desiFish/EPaper-Display-NTP-Clock/src/images/x6.jpg

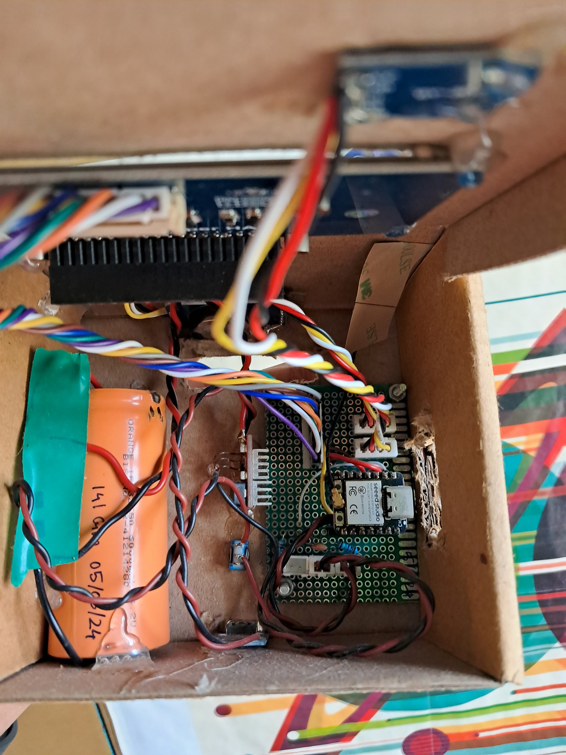
src/images/x6.jpg
