desiFish/EPaper-Display-NTP-Clock/(threads)

Thread 2 (2024-06-30):

Add Settings Button

KamadoTanjiro-beep, 2024-06-30:
A settings button is needed for entering WiFi manager page.

desiFish, 2024-12-30:
Successfully tested the debug/settings switch on Weather Clock, the same can be applied to this clock

Thread 7 (2025-01-11):

Interrupt Based Update

desiFish, 2025-01-11:
Connection of INT Pin of DS3231 to wake up esp32 from deep sleep and update time. Internal RTC-based wakeup works just fine, but with one drawback: ESP32 has no way of knowing if a minute has passed in real-time so it may wake up a bit sooner or later. The time displayed on the Epaper display will always be within a 1-minute range. But with INTERRUPT-based-wake-up, it will always show accurate time.

Resource:
[Link1](https://garrysblog.com/2020/07/05/using-the-ds3231-real-time-clock-alarm-with-the-adafruit-rtclib-library/)
[Link2](https://wiki.eolab.de/doku.php?id=amc2020:group_n:deepsleep)

desiFish, 2025-04-06:
done

Closed 2025-04-06.
