desiFish/EPaper-Display-NTP-Clock/(commit log)

2025-01-10 Add important safety notes and warnings regarding battery configuration, USB charging, voltage compatibility, and enclosure design to README.md
2025-01-10 Update image paths in README.md to reflect new directory structure and add battery performance analysis section
2025-01-10 Add additional battery life analysis tests and enhance image gallery in README.md
2025-01-10 Update README.md with display specifications, current draw values, and improved image descriptions
2025-01-10 reverting back to previous stable version
    [epdNtpClockV1.ino]
2025-01-10 Update image and caption for ESP32 C3 & C6 in README.md
2025-01-10 Add battery life analysis table and update performance metrics in README.md
2025-01-11 Update battery life analysis table and add safety notes for DS3231 and TP5000
2025-01-14 Update README.md to clarify deep sleep current specifications and enhance description of ESP32 C6 variant
2025-01-29 (untested) Improved efficiency of overall code.
    Better organisation
    Univeral XIAO Devices compatibility
    Other fixes.
    [epdNtpClockV1.ino, epdif.h]
2025-04-05 Latest fix for time not displaying
    [epd3in52.ino, epdNtpClockV1.ino]
2025-04-05 Refactor battery monitoring and font variable declarations for clarity and efficiency
2025-04-05 Fix component name in README.md and update pin definitions for ESP32 C6 in epdif.h
    [epdif.h]
2025-04-05 Fix formatting issue in README.md for deep sleep current note
2025-04-05 Update USB connection warning for ESP32C6 and clarify battery disconnection instructions
2025-04-06 Refactor autoTimeUpdate function for improved clarity and efficiency; update error handling and battery level display logic
    [epdNtpClockV1.ino]
2025-04-06 Update README.md for improved clarity on display specifications, power source, and deep sleep implementation details
2025-04-06 Fix typo in README.md regarding DS3231 RTC pin connection
2025-04-07 Added new images, memory optimisations, performance optimisations, documentation improvements, upgraded battery UI
2025-09-09 Update battery life analysis test number in README.md
