desiFish/EPaper-Display-NTP-Clock/src/images/x11.jpg

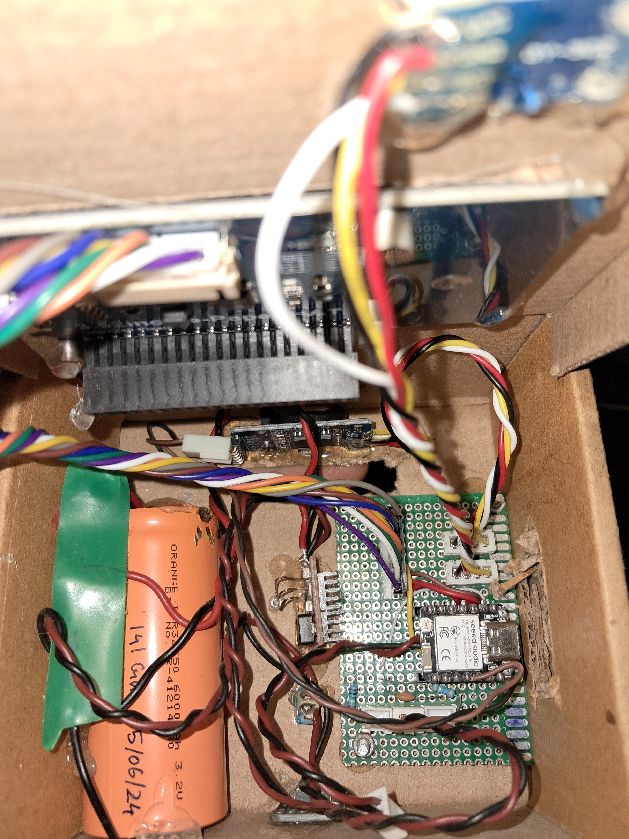
[picture p17: src/images/x11.jpg]
src/images/x11.jpg
