desiFish/EPaper-Display-NTP-Clock/src/images/x12.jpg

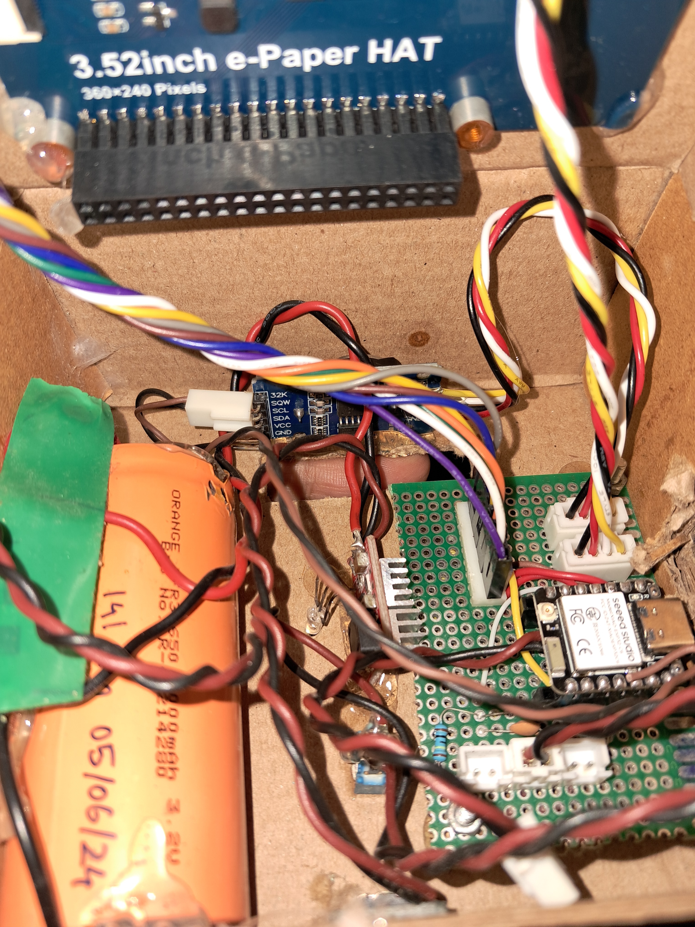
[picture p18: src/images/x12.jpg]
src/images/x12.jpg
