desiFish/EPaper-Display-NTP-Clock/src/images/x13.jpg

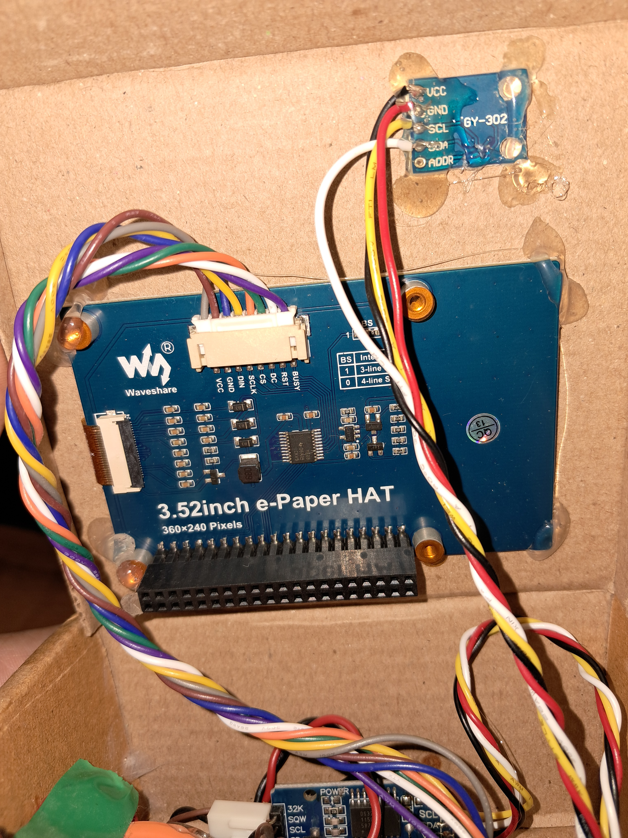
[picture p19: src/images/x13.jpg]
src/images/x13.jpg
